thisoldgeek/DieselPunk-Cellphone/DPC_VCarve_Walnut_NO_Badge_v2_1_Job_Setup_Sheet.html

Job Setup Sheet

DPC_VCarve_Walnut_NO_Badge_v2_1

Job Layout

Material Border

Material Setup

Material Block:

Height(Y):12" Width(X):12" Depth(Z):0.52"

Home / Start Position:

X:0" Y:0" Z:1.251"

Datum Position:
Z-Zero:Bottom of Material

XY: Bottom Left Corner

Clearance Z1: 0.5"

Toolpaths Summary

Toolpaths : 17

Top Pocket [Clear]

Top Pocket

Bottom Pocket [Clear]

Bottom Pocket

PCB Mount Pockets [Clear]

PCB Mount Pockets

Drill PCB Mount Holes

Drill Bottom Thru Holes

Metsl Inserts .35in

Top Profile Speaker

Microphone Profile

OLED Profile

Keypad Profile

On Off Switch Profile

Both Outside Profiles

Both USB Pockets [Clear]

Both USB Pockets

Tool Name:

[1] End Mill (0.125 inch)

[1] End Mill (0.125 inch)

[1] End Mill (0.125 inch)

[1] End Mill (0.125 inch)

[1] End Mill (0.125 inch)

[1] End Mill (0.125 inch)

[1] End Mill (0.125 inch)

[1] End Mill (0.125 inch)

[1] End Mill (0.125 inches)

[1] End Mill (0.125 inch)

[1] End Mill (0.125 inch)

[1] End Mill (0.125 inch)

[1] End Mill (0.125 inch)

[1] End Mill (0.125 inch)

[1] End Mill (0.125 inch)

[1] End Mill (0.125 inch)

[1] End Mill (0.125 inch)

Time Estimate : 00:27:44

00:04:24

00:00:23

00:04:26

00:03:28

00:00:12

00:00:56

00:00:09

00:00:21

00:00:53

00:00:59

00:00:27

00:00:39

00:01:38

00:00:23

00:06:40

00:00:24

00:01:22

Toolpath: Top Pocket [Clear]

Toolpath Info

Time Estimate: 00:04:24

Toolpath Type: Pocket Toolpath

Feed Rate: 100 inch/min

Plunge Rate: 30 inch/min

Spindle Speed: 12000

Tool Info

Tool Name: End Mill (0.125 inch)

Tool Type: End Mill

Tool Number: 1

Max Cut Depth: 0.375

Pass Depth: 0.4"

Stepover: 0.05"

Toolpath: Top Pocket

Toolpath Info

Time Estimate: 00:00:23

Toolpath Type: Pocket Toolpath

Feed Rate: 100 inch/min

Plunge Rate: 30 inch/min

Spindle Speed: 12000

Tool Info

Tool Name: End Mill (0.125 inch)

Tool Type: End Mill

Tool Number: 1

Max Cut Depth: 0.375

Pass Depth: 0.4"

Stepover: 0.05"

Toolpath: Bottom Pocket [Clear]

Toolpath Info

Time Estimate: 00:04:26

Toolpath Type: Pocket Toolpath

Feed Rate: 100 inch/min

Plunge Rate: 30 inch/min

Spindle Speed: 12000

Tool Info

Tool Name: End Mill (0.125 inch)

Tool Type: End Mill

Tool Number: 1

Max Cut Depth: 0.375

Pass Depth: 0.4"

Stepover: 0.05"

Toolpath: Bottom Pocket

Toolpath Info

Time Estimate: 00:03:28

Toolpath Type: Pocket Toolpath

Feed Rate: 0.5 inch/sec

Plunge Rate: 0.5 inch/sec

Spindle Speed: 12000

Tool Info

Tool Name: End Mill (0.125 inch)

Tool Type: End Mill

Tool Number: 1

Max Cut Depth: 0.375

Pass Depth: 0.18"

Stepover: 0.08"

Toolpath: PCB Mount Pockets [Clear]

Toolpath Info

Time Estimate: 00:00:12

Toolpath Type: Pocket Toolpath

Feed Rate: 100 inch/min

Plunge Rate: 30 inch/min

Spindle Speed: 12000

Tool Info

Tool Name: End Mill (0.125 inch)

Tool Type: End Mill

Tool Number: 1

Max Cut Depth: 0.236

Pass Depth: 0.4"

Stepover: 0.05"

Toolpath: PCB Mount Pockets

Toolpath Info

Time Estimate: 00:00:56

Toolpath Type: Pocket Toolpath

Feed Rate: 0.5 inch/sec

Plunge Rate: 0.5 inch/sec

Spindle Speed: 12000

Tool Info

Tool Name: End Mill (0.125 inch)

Tool Type: End Mill

Tool Number: 1

Max Cut Depth: 0.236

Pass Depth: 0.18"

Stepover: 0.08"

Toolpath: Drill PCB Mount Holes

Toolpath Info

Time Estimate: 00:00:09

Toolpath Type: Drilling Toolpath

Feed Rate: 0.5 inch/sec

Plunge Rate: 0.5 inch/sec

Spindle Speed: 12000

Tool Info

Tool Name: End Mill (0.125 inch)

Tool Type: End Mill

Tool Number: 1

Max Cut Depth: 0.381

Pass Depth: 0.18"

Stepover: 0.08"

Toolpath: Drill Bottom Thru Holes

Toolpath Info

Time Estimate: 00:00:21

Toolpath Type: Drilling Toolpath

Feed Rate: 0.5 inch/sec

Plunge Rate: 0.5 inch/sec

Spindle Speed: 12000

Tool Info

Tool Name: End Mill (0.125 inch)

Tool Type: End Mill

Tool Number: 1

Max Cut Depth: 0.52

Pass Depth: 0.18"

Stepover: 0.08"

Toolpath: Metsl Inserts .35in

Toolpath Info

Time Estimate: 00:00:53

Toolpath Type: Pocket Toolpath

Feed Rate: 100 inch/min

Plunge Rate: 30 inch/min

Spindle Speed: 12000

Tool Info

Tool Name: End Mill (0.125 inches)

Tool Type: End Mill

Tool Number: 1

Max Cut Depth: 0.381

Pass Depth: 0.125"

Stepover: 0.05"

Toolpath: Top Profile Speaker

Toolpath Info

Time Estimate: 00:00:59

Toolpath Type: 2D Profile Toolpath

Feed Rate: 0.5 inch/sec

Plunge Rate: 0.5 inch/sec

Spindle Speed: 12000

Tool Info

Tool Name: End Mill (0.125 inch)

Tool Type: End Mill

Tool Number: 1

Max Cut Depth: 0.52

Pass Depth: 0.18"

Stepover: 0.08"

Toolpath: Microphone Profile

Toolpath Info

Time Estimate: 00:00:27

Toolpath Type: 2D Profile Toolpath

Feed Rate: 0.5 inch/sec

Plunge Rate: 0.5 inch/sec

Spindle Speed: 12000

Tool Info

Tool Name: End Mill (0.125 inch)

Tool Type: End Mill

Tool Number: 1

Max Cut Depth: 0.52

Pass Depth: 0.18"

Stepover: 0.08"

Toolpath: OLED Profile

Toolpath Info

Time Estimate: 00:00:39

Toolpath Type: 2D Profile Toolpath

Feed Rate: 0.5 inch/sec

Plunge Rate: 0.5 inch/sec

Spindle Speed: 12000

Tool Info

Tool Name: End Mill (0.125 inch)

Tool Type: End Mill

Tool Number: 1

Max Cut Depth: 0.52

Pass Depth: 0.18"

Stepover: 0.08"

Toolpath: Keypad Profile

Toolpath Info

Time Estimate: 00:01:38

Toolpath Type: 2D Profile Toolpath

Feed Rate: 0.5 inch/sec

Plunge Rate: 0.5 inch/sec

Spindle Speed: 12000

Tool Info

Tool Name: End Mill (0.125 inch)

Tool Type: End Mill

Tool Number: 1

Max Cut Depth: 0.52

Pass Depth: 0.18"

Stepover: 0.08"

Toolpath: On Off Switch Profile

Toolpath Info

Time Estimate: 00:00:23

Toolpath Type: 2D Profile Toolpath

Feed Rate: 0.5 inch/sec

Plunge Rate: 0.5 inch/sec

Spindle Speed: 12000

Tool Info

Tool Name: End Mill (0.125 inch)

Tool Type: End Mill

Tool Number: 1

Max Cut Depth: 0.52

Pass Depth: 0.18"

Stepover: 0.08"

Toolpath: Both Outside Profiles

Toolpath Info

Time Estimate: 00:06:40

Toolpath Type: 2D Profile Toolpath

Feed Rate: 0.5 inch/sec

Plunge Rate: 0.5 inch/sec

Spindle Speed: 12000

Tool Info

Tool Name: End Mill (0.125 inch)

Tool Type: End Mill

Tool Number: 1

Max Cut Depth: 0.52

Pass Depth: 0.18"

Stepover: 0.08"

Toolpath: Both USB Pockets [Clear]

Toolpath Info

Time Estimate: 00:00:24

Toolpath Type: Pocket Toolpath

Feed Rate: 100 inch/min

Plunge Rate: 30 inch/min

Spindle Speed: 12000

Tool Info

Tool Name: End Mill (0.125 inch)

Tool Type: End Mill

Tool Number: 1

Max Cut Depth: 0.375

Pass Depth: 0.4"

Stepover: 0.05"

Toolpath: Both USB Pockets

Toolpath Info

Time Estimate: 00:01:22

Toolpath Type: Pocket Toolpath

Feed Rate: 100 inch/min

Plunge Rate: 30 inch/min

Spindle Speed: 12000

Tool Info

Tool Name: End Mill (0.125 inch)

Tool Type: End Mill

Tool Number: 1

Max Cut Depth: 0.375

Pass Depth: 0.125"

Stepover: 0.05"

Job Setup Sheet v1.7
