thisoldgeek/DieselPunk-Cellphone/DPC_VCarve_Feather_Fona_r1_1_NO_BADGE.pdf

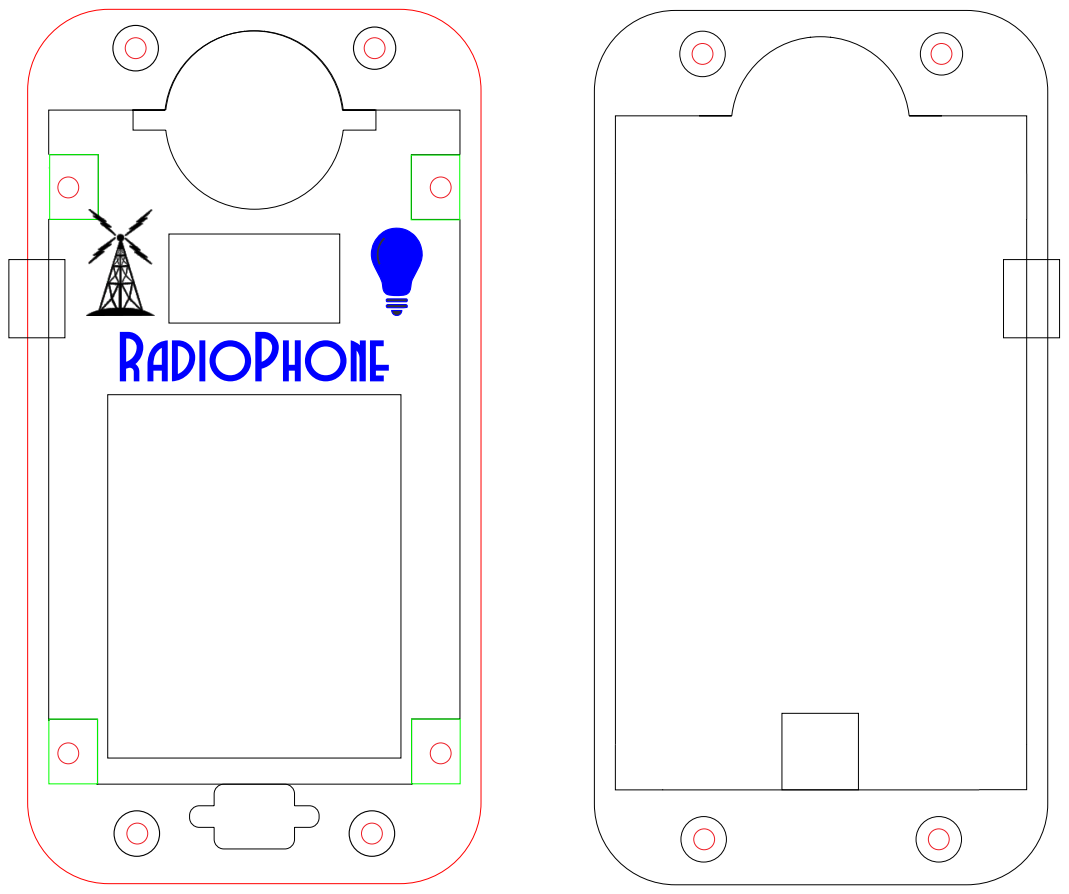
[picture p1: page 1]
