thisoldgeek/DieselPunk-Cellphone/DPC_VCarve_Feather_Fona_r1.pdf

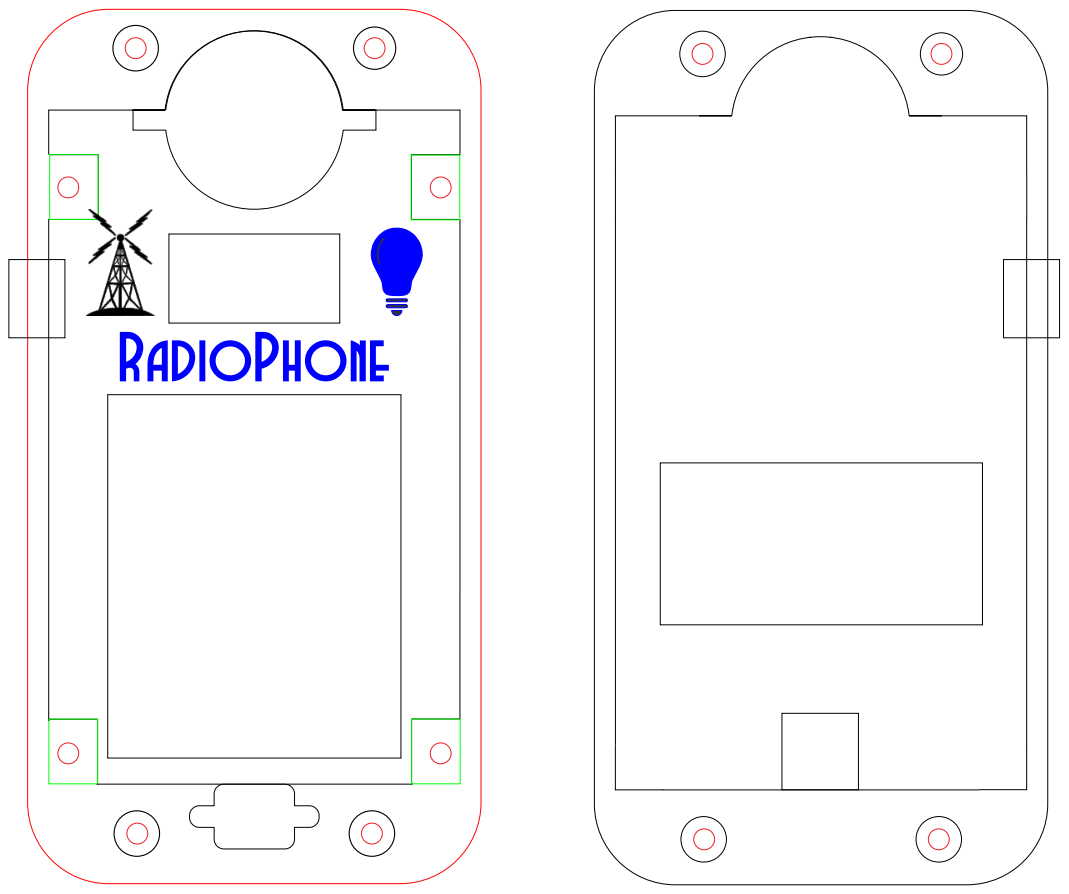
[picture p2: page 1]
