thisoldgeek/DieselPunk-Cellphone/DPC_Wood_motorola_name_plate_r1.pdf

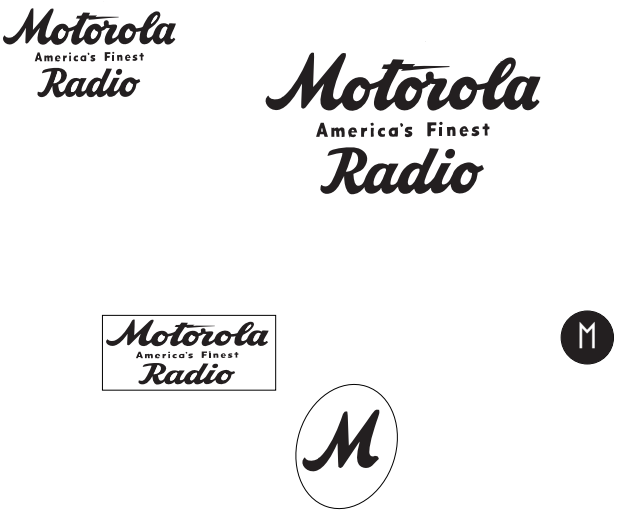
[picture p3: page 1]
